abhijeetsomashila1/Indoor-AQ-BIQ/(commit log)

2026-08-21 Replace API URL with placeholder
    Updated API URL to a placeholder for security.
    [indoor-aq.ino]
2026-09-07 ctOP demo board code
2026-09-24 Changed Co2 from pwm to UART
2026-09-26 Added Co2 sensor datasheet
2026-09-29 Create Prana CO2 Sensor Calibration Procedure.pdf
2026-10-13 Added Calibration code
